InterstitialTech/seismobot-hardware/kicad/seismobot-hardware.png

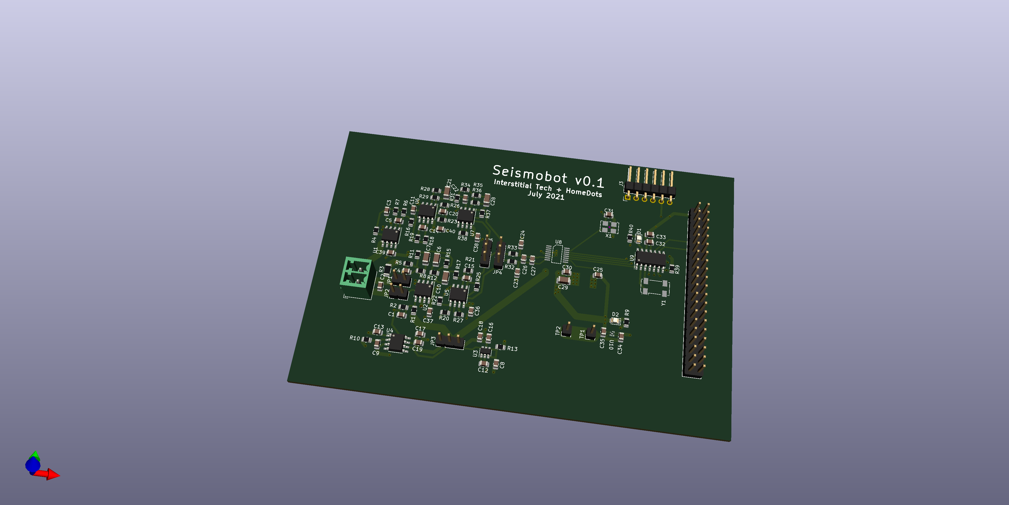
kicad/seismobot-hardware.png
