InterstitialTech/seismobot-hardware/README.md

# seismobot-hardware
Geophone DAQ board: KiCad project files

Schematic
