InterstitialTech/seismobot-hardware/kicad-mini/seismobot-hardware-mini/seismobot-hardware-mini-quad-solid.kicad_pcb

## KiCad design kicad-mini/seismobot-hardware-mini/seismobot-hardware-mini-quad-solid.kicad_pcb (2022-04-04)

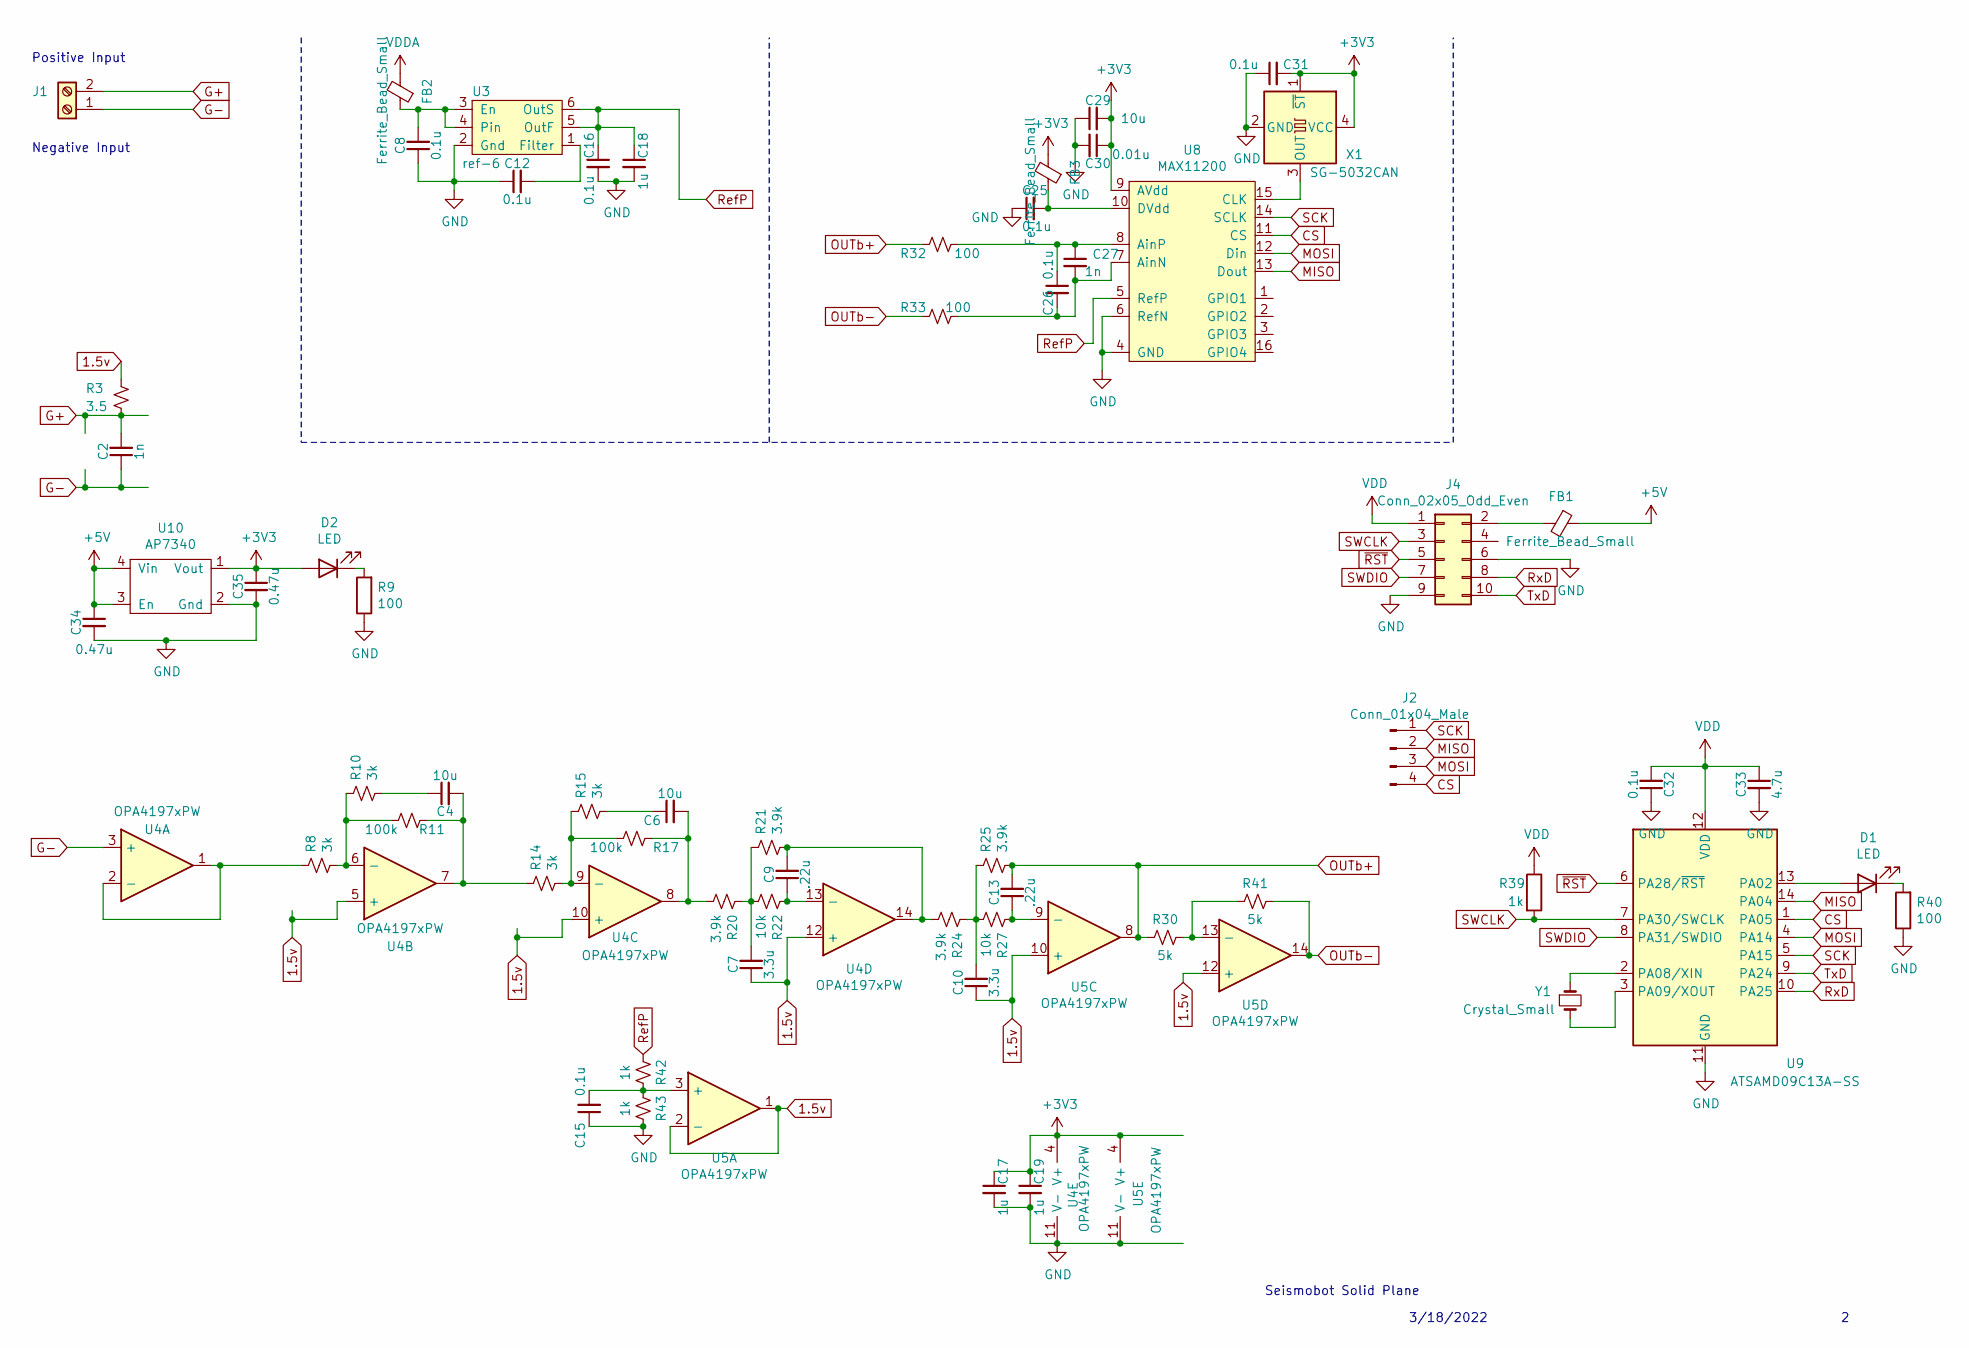
[picture p2: schematic seismobot-hardware-mini-quad-solid.sch]

Parts:
C2, C27: 1n; C_0805_2012Metric
C4, C6, C29: 10u; C_1206_3216Metric
C7, C10: 3.3u; C_0805_2012Metric
C8, C12, C15, C16, C25, C26, C31, C32: 0.1u; C_0805_2012Metric
C9, C13: .22u; C_0805_2012Metric
C17, C18, C19: 1u; C_0805_2012Metric
C30: 0.01u; C_0805_2012Metric
C33: 4.7u; C_0805_2012Metric
C34, C35: 0.47u; C_0805_2012Metric
D1, D2: LED; LED_0805_2012Metric
FB1, FB2, FB3: Ferrite_Bead_Small; R_0805_2012Metric
J1: Screw_Terminal_01x02; PhoenixContact_MCV_1,5_2-G-3.5_1x02_P3.50mm_Vertical
J2: Conn_01x04_Male; PinHeader_1x04_P1.27mm_Vertical
J4: Conn_02x05_Odd_Even; PinSocket_2x05_P2.54mm_Vertical
R3: 3.5; R_1206_3216Metric
R8, R10, R14, R15: 3k; R_0805_2012Metric
R9, R32, R33, R40: 100; R_0805_2012Metric
R11, R17: 100k; R_0805_2012Metric
R20, R21, R24, R25: 3.9k; R_0805_2012Metric
R22, R27: 10k; R_0805_2012Metric
R30, R41: 5k; R_0805_2012Metric
R39, R42, R43: 1k; R_0805_2012Metric
U3: ref-6; SOT-23-6
U4, U5: OPA4197xPW; SOIC-14_3.9x8.7mm_P1.27mm
U8: MAX11200; QSOP-16
U9: ATSAMD09C13A-SS; SOIC-14_3.9x8.7mm_P1.27mm
U10: AP7340; DFN-1010-4
X1: SG-5032CAN; Oscillator_SMD_SeikoEpson_SG8002LB-4Pin_5.0x3.2mm
Y1: Crystal_Small; Crystal_SMD_3215-2Pin_3.2x1.5mm

Connections:
1.5v: C7.1, C10.1, R3.1, U4.5 (+), U4.10 (+), U4.12 (+), U5.1, U5.2 (-), U5.10 (+), U5.12 (+)
+5V: C34.1, FB1.1, U10.3 (En), U10.4 (Vin)
CS: J2.4, U8.11 (CS), U9.1 (PA05)
G+: C2.2, J1.2, R3.2
G-: C2.1, J1.1, U4.3 (+)
GND: C8.1, C12.1, C15.1, C16.2, C17.2, C18.2, C19.2, C25.1, C29.1, C30.2, C31.1, C32.1, C33.2, C34.2, C35.2, J4.6, J4.9, R9.1, R40.1, R43.1, U3.2 (Gnd), U4.11 (V-), U5.11 (V-), U8.4 (GND), U8.6 (RefN), U9.11 (GND), U10.2 (Gnd), X1.2 (GND); also elsewhere on the board
MISO: J2.2, U8.13 (Dout), U9.14 (PA04)
MOSI: J2.3, U8.12 (Din), U9.4 (PA14)
unnamed: C4.1, R10.2
unnamed: C4.2, R11.1, R14.1, U4.7
unnamed: C6.1, R15.2
unnamed: C6.2, R17.1, R20.2, U4.8
unnamed: C7.2, R20.1, R21.1, R22.2
unnamed: C8.2, FB2.1, U3.3 (En), U3.4
unnamed: C9.1, R22.1, U4.13 (-)
unnamed: C9.2, R21.2, R24.2, U4.14
unnamed: C10.2, R24.1, R25.1, R27.2
unnamed: C12.2, U3.1 (Filter)
unnamed: C13.1, R27.1, U5.9 (-)
unnamed: C15.2, R42.1, R43.2, U5.3 (+)
unnamed: C26.1, C27.1, R32.1, U8.8 (AinP)
unnamed: C26.2, C27.2, R33.1, U8.7 (AinN)
unnamed: D1.1 (K), R40.2
unnamed: D1.2 (A), U9.13 (PA02)
unnamed: D2.1 (K), R9.2
unnamed: FB1.2, J4.2
unnamed: R8.1, U4.1, U4.2 (-)
unnamed: R8.2, R10.1, R11.2, U4.6 (-)
unnamed: R14.2, R15.1, R17.2, U4.9 (-)
unnamed: R30.1, R41.2, U5.13 (-)
unnamed: U8.15 (CLK), X1.3 (OUT)
unnamed: U9.2 (PA08/XIN), Y1.1
unnamed: U9.3 (PA09/XOUT), Y1.2
OUTb+: C13.2, R25.2, R30.2, R32.2, U5.8
OUTb-: R33.2, R41.1, U5.14
RefP: C16.1, C18.1, R42.2, U3.5 (OutF), U3.6 (OutS), U8.5 (RefP)
RxD: J4.8, U9.10 (PA25)
SCK: J2.1, U8.14 (SCLK), U9.5 (PA15)
SWCLK: J4.3, R39.2, U9.7 (PA30/SWCLK)
SWDIO: J4.7, U9.8 (PA31/SWDIO)
TxD: J4.10, U9.9 (PA24)
VDD: C32.2, C33.1, J4.1, R39.1, U9.12 (VDD); also elsewhere on the board
~RST: J4.5, U9.6 (PA28/~RST)

Notes on the sheet:
Negative Input
Positive Input
Seismobot Solid Plane
3/18/2022

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
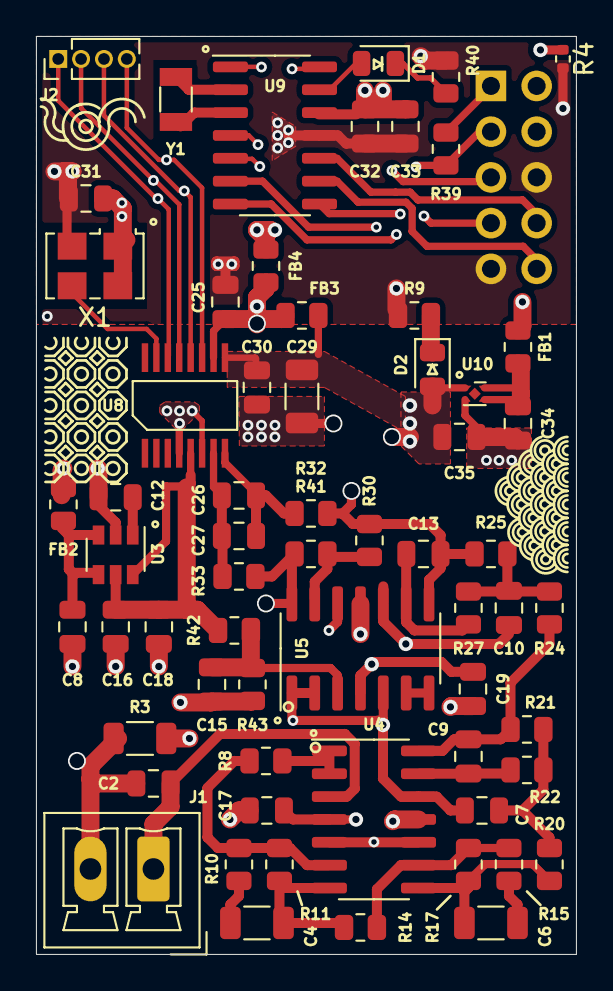
[picture p3: board seismobot-hardware-mini-quad-solid.kicad_pcb from above]

Board: 4 copper layers, 30.0 x 51.0 mm, 64 parts (1 on the bottom side), 45 nets.

Other parts of the board:
FB4: 0; R_0805_2012Metric
R4: 0; R_0402_1005Metric

Their connections:
GND: R4.2; also elsewhere on the board
VDD: FB4.1; also elsewhere on the board
