InterstitialTech/seismobot-hardware/kicad/seismobot-hardware.kicad_pcb

## KiCad design kicad/seismobot-hardware.kicad_pcb (2021-11-17)

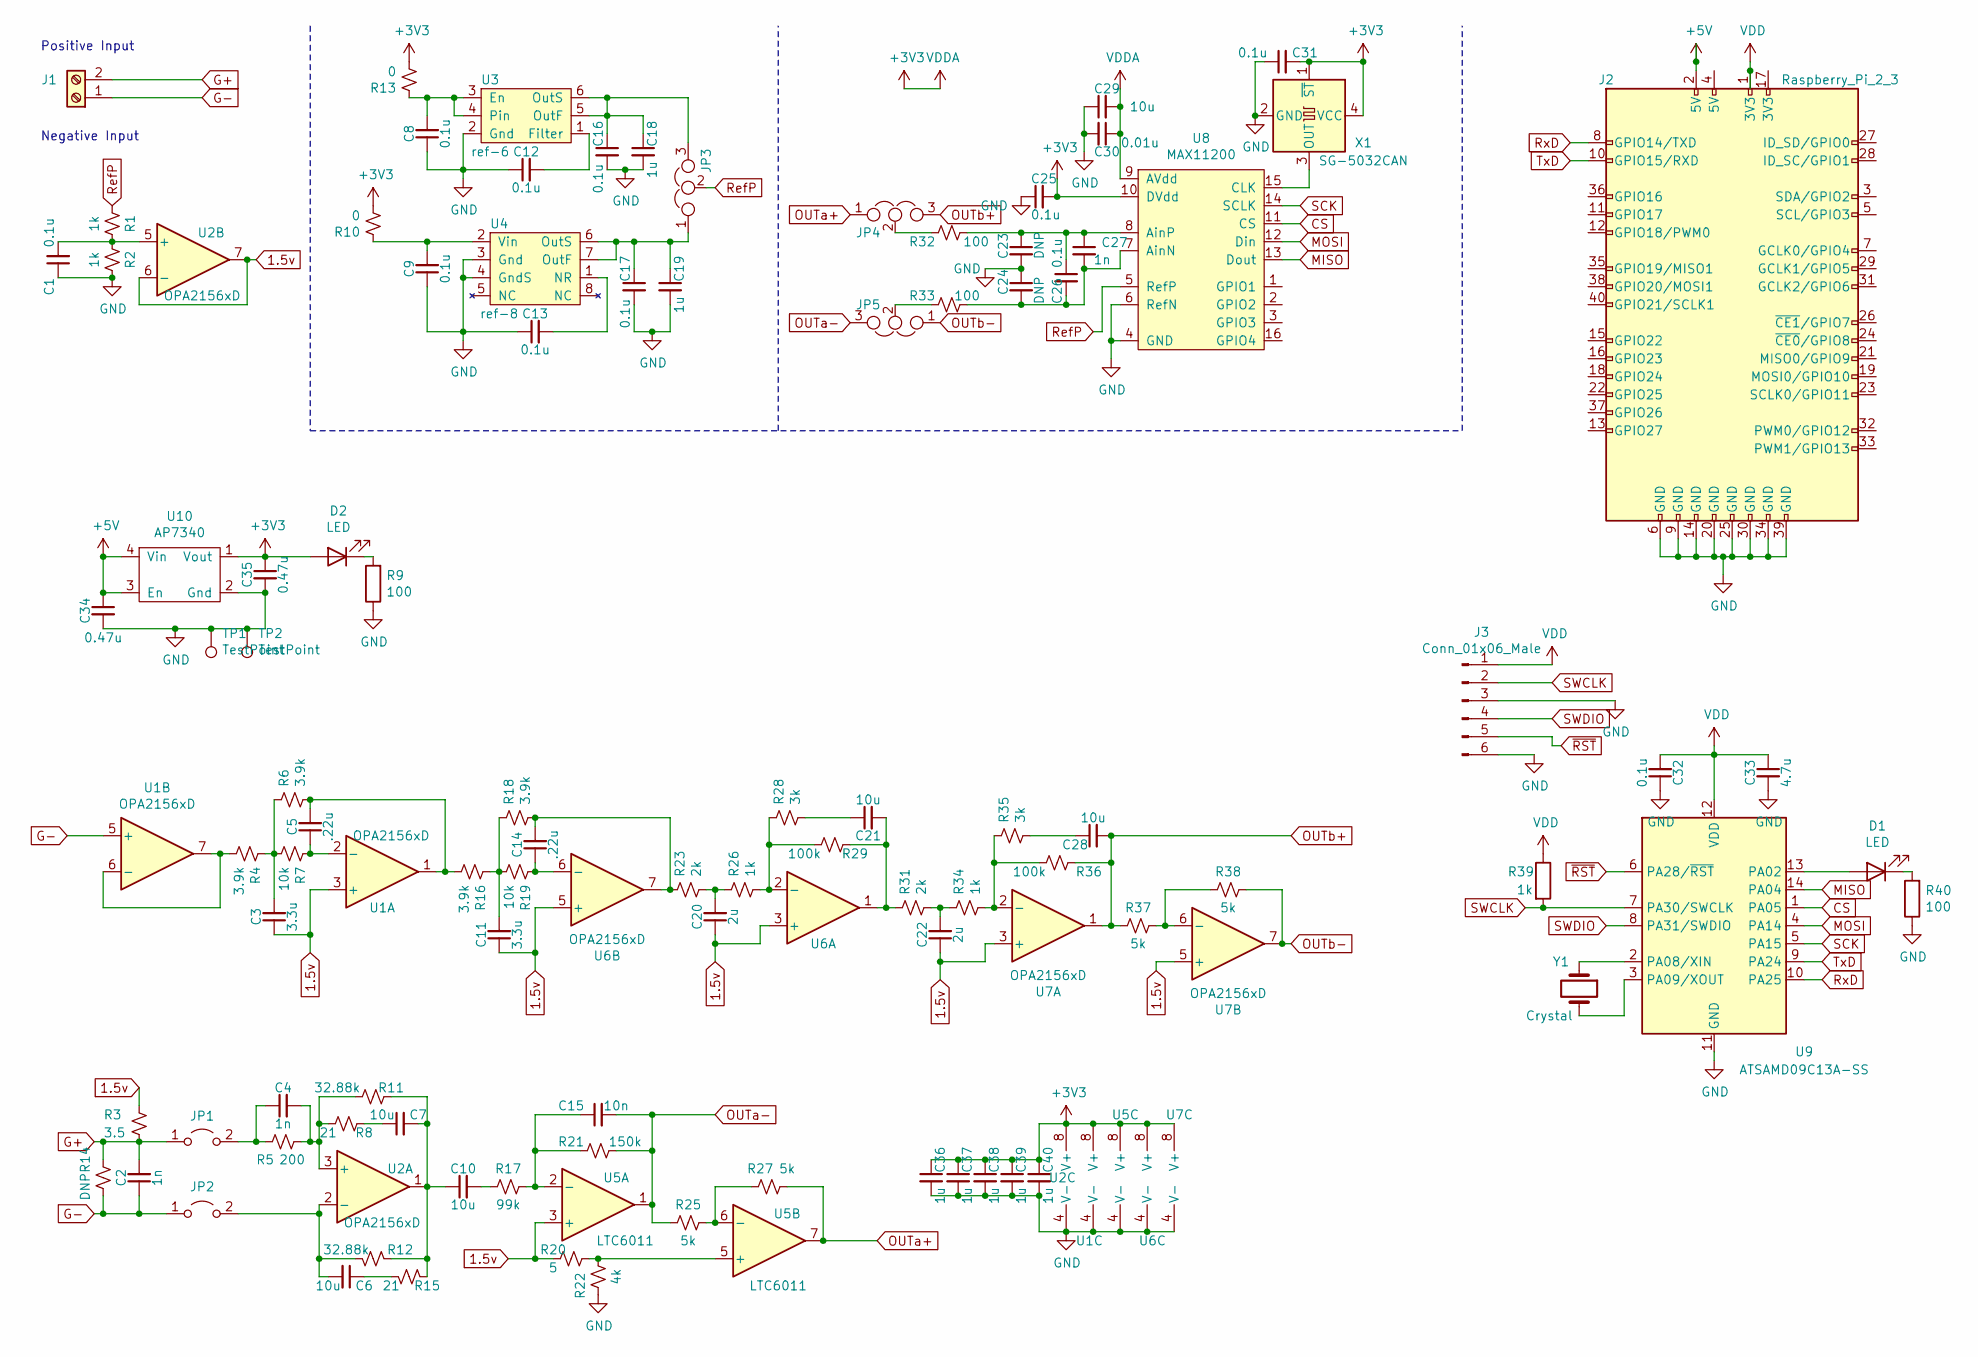
[picture p4: schematic seismobot-hardware.sch]

Parts:
C1, C8, C9, C12, C13, C16, C17, C25, C26, C31, C32: 0.1u; C_0805_2012Metric
C2, C4, C27: 1n; C_0805_2012Metric
C3, C11: 3.3u; C_0805_2012Metric
C5, C14: .22u; C_0805_2012Metric
C6, C7, C10, C21, C28, C29: 10u; C_1206_3216Metric
C15: 10n; C_0805_2012Metric
C18, C19, C36, C37, C38, C39, C40: 1u; C_0805_2012Metric
C20, C22: 2u; C_0805_2012Metric
C23, C24: DNP; C_0805_2012Metric
C30: 0.01u; C_0805_2012Metric
C33: 4.7u; C_0805_2012Metric
C34, C35: 0.47u; C_0805_2012Metric
D1, D2: LED; LED_0805_2012Metric
J1: Screw_Terminal_01x02; PhoenixContact_MCV_1,5_2-G-3.5_1x02_P3.50mm_Vertical
J2: Raspberry_Pi_2_3; PinHeader_2x20_P2.54mm_Vertical
J3: Conn_01x06_Male; PinHeader_1x06_P2.54mm_Horizontal
JP1, JP2: Jumper_2_Open; PinHeader_1x02_P2.54mm_Vertical
JP3, JP4, JP5: Jumper_NC_Dual; PinHeader_1x03_P2.54mm_Vertical
R1, R2, R26, R34, R39: 1k; R_0805_2012Metric
R3: 3.5; R_1206_3216Metric
R4, R6, R16, R18: 3.9k; R_0805_2012Metric
R5: 200; R_0805_2012Metric
R7, R19: 10k; R_0805_2012Metric
R8, R15: 21; R_0805_2012Metric
R9, R32, R33, R40: 100; R_0805_2012Metric
R10, R13: 0; R_0805_2012Metric
R11, R12: 32.88k; R_0805_2012Metric
R14: DNP; R_0805_2012Metric
R17: 99k; R_0805_2012Metric
R20: 5; R_0805_2012Metric
R21: 150k; R_0805_2012Metric
R22: 4k; R_0805_2012Metric
R23, R31: 2k; R_0805_2012Metric
R25, R27, R37, R38: 5k; R_0805_2012Metric
R28, R35: 3k; R_0805_2012Metric
R29, R36: 100k; R_0805_2012Metric
TP1, TP2: TestPoint; PinHeader_1x01_P2.54mm_Vertical
U1, U2, U6, U7: OPA2156xD; SOIC-8_3.9x4.9mm_P1.27mm
U3: ref-6; SOT-23-6
U4: ref-8; SOIC-8_3.9x4.9mm_P1.27mm
U5: LTC6011; SOIC-8_3.9x4.9mm_P1.27mm
U8: MAX11200; QSOP-16
U9: ATSAMD09C13A-SS; SOIC-14_3.9x8.7mm_P1.27mm
U10: AP7340; DFN-1010-4
X1: SG-5032CAN; Oscillator_SMD_SeikoEpson_SG8002LB-4Pin_5.0x3.2mm
Y1: Crystal; Crystal_SMD_Suntsu_SWS83412D16-4Pin_8.0x3.8mm

Connections:
1.5v: C3.1, C11.1, C20.1, C22.1, R3.1, R20.2, U1.3 (+), U2.6 (-), U2.7, U5.3 (+), U6.3 (+), U6.5 (+), U7.3 (+), U7.5 (+)
+3V3: C25.2, C29.2, C30.1, C31.2, C35.1, C36.1, C37.1, C38.1, C39.1, C40.1, D2.2 (A), R10.1, R13.1, U1.8 (V+), U2.8 (V+), U5.8 (V+), U6.8 (V+), U7.8 (V+), U8.9 (AVdd), U8.10 (DVdd), U10.1 (Vout), X1.1 (~ST), X1.4 (VCC)
+5V: C34.1, J2.2 (5V), U10.3 (En), U10.4 (Vin)
CS: U8.11 (CS), U9.1 (PA05)
G+: C2.2, J1.2, JP1.1 (A), R3.2, R14.2
G-: C2.1, J1.1, JP2.1 (A), R14.1, U1.5 (+)
GND: C1.1, C8.1, C9.1, C12.1, C13.1, C16.2, C17.2, C18.2, C19.2, C23.2, C24.1, C25.1, C29.1, C30.2, C31.1, C32.1, C33.2, C34.2, C35.2, C36.2, C37.2, C38.2, C39.2, C40.2, J2.6 (GND), J2.9 (GND), J2.14 (GND), J2.20 (GND), J2.25 (GND), J2.30 (GND), J2.34 (GND), J2.39 (GND), J3.3, J3.6, R2.1, R9.1, R22.1, R40.1, TP1.1, TP2.1, U1.4 (V-), U2.4 (V-), U3.2 (Gnd), U4.3 (Gnd), U4.4 (GndS), U5.4 (V-), U6.4 (V-), U7.4 (V-), U8.4 (GND), U8.6 (RefN), U9.11 (GND), U10.2 (Gnd), X1.2 (GND)
MISO: U8.13 (Dout), U9.14 (PA04)
MOSI: U8.12 (Din), U9.4 (PA14)
unnamed: C1.2, R1.1, R2.2, U2.5 (+)
unnamed: C3.2, R4.1, R6.1, R7.2
unnamed: C4.1, JP1.2 (B), R5.2
unnamed: C4.2, R5.1, R8.2, R11.2, U2.3 (+)
unnamed: C5.1, R7.1, U1.2 (-)
unnamed: C5.2, R6.2, R16.2, U1.1
unnamed: C6.1, R15.1
unnamed: C6.2, JP2.2 (B), R12.1, U2.2 (-)
unnamed: C7.1, R8.1
unnamed: C8.2, R13.2, U3.3 (En), U3.4
unnamed: C9.2, R10.2, U4.2 (Vin)
unnamed: C7.2, C10.1, R11.1, R12.2, R15.2, U2.1
unnamed: C10.2, R17.2
unnamed: C11.2, R16.1, R18.1, R19.2
unnamed: C12.2, U3.1 (Filter)
unnamed: C13.2, U4.1 (NR)
unnamed: C14.1, R19.1, U6.6 (-)
unnamed: C14.2, R18.2, R23.1, U6.7
unnamed: C15.1, R17.1, R21.2, U5.2 (-)
unnamed: C16.1, C18.1, JP3.3, U3.5 (OutF), U3.6 (OutS)
unnamed: C17.1, C19.1, JP3.1, U4.6 (OutS), U4.7 (OutF)
unnamed: C20.2, R23.2, R26.1
unnamed: C21.1, R28.2
unnamed: C21.2, R29.1, R31.1, U6.1
unnamed: C22.2, R31.2, R34.1
unnamed: C23.1, C26.1, C27.1, R32.1, U8.8 (AinP)
unnamed: C24.2, C26.2, C27.2, R33.1, U8.7 (AinN)
unnamed: C28.1, R35.2
unnamed: D1.1 (K), R40.2
unnamed: D1.2 (A), U9.13 (PA02)
unnamed: D2.1 (K), R9.2
unnamed: JP4.2, R32.2
unnamed: JP5.2, R33.2
unnamed: R4.2, U1.6 (-), U1.7
unnamed: R20.1, R22.2, U5.5 (+)
unnamed: R25.1, R27.2, U5.6 (-)
unnamed: R26.2, R28.1, R29.2, U6.2 (-)
unnamed: R34.2, R35.1, R36.2, U7.2 (-)
unnamed: R37.1, R38.2, U7.6 (-)
unnamed: U8.15 (CLK), X1.3 (OUT)
unnamed: U9.2 (PA08/XIN), Y1.1
unnamed: U9.3 (PA09/XOUT), Y1.4
OUTa+: JP4.1, R27.1, U5.7
OUTa-: C15.2, JP5.3, R21.1, R25.2, U5.1
OUTb+: C28.2, JP4.3, R36.1, R37.2, U7.1
OUTb-: JP5.1, R38.1, U7.7
RefP: JP3.2, R1.2, U8.5 (RefP)
RxD: J2.8 (GPIO14/TXD), U9.10 (PA25)
SCK: U8.14 (SCLK), U9.5 (PA15)
SWCLK: J3.2, R39.2, U9.7 (PA30/SWCLK)
SWDIO: J3.4, U9.8 (PA31/SWDIO)
TxD: J2.10 (GPIO15/RXD), U9.9 (PA24)
VDD: C32.2, C33.1, J2.1 (3V3), J3.1, R39.1, U9.12 (VDD)
~RST: J3.5, U9.6 (PA28/~RST)

Notes on the sheet:
Negative Input
Positive Input

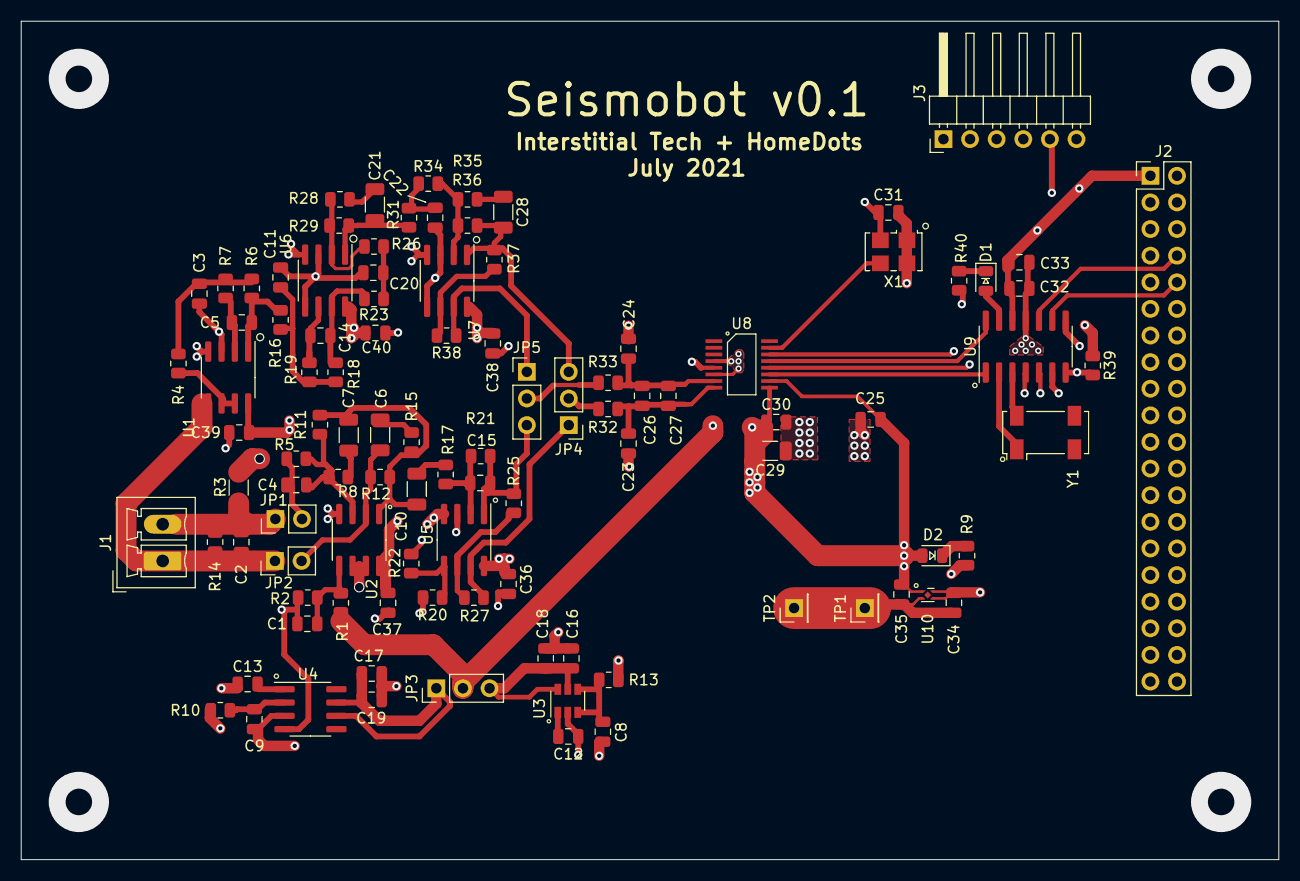
[picture p5: board seismobot-hardware.kicad_pcb from above]

Board: 4 copper layers, 120.0 x 80.0 mm, 102 parts (0 on the bottom side), 63 nets.
