InterstitialTech/seismobot-hardware/(commit log)

2021-04-29 add bom.csv
    [bom.csv]
2021-04-30 bom.csv: change from 26 to 40 pin header
    [bom.csv]
2021-05-05 added kicad project
    [seismobot-hardware.kicad_pcb, seismobot-hardware.sch]
2021-05-05 raspberry pi header and mcu on schematic
    [seismobot-hardware.sch]
2021-05-19 add MCU (ATSAMD09) and supporting circuitry
    [bom.csv, prebom.csv, seismobot-hardware.sch]
2021-05-21 Added passives and clock to ADC
    Based off of dev board
    [seismobot-hardware.sch]
2021-05-21 started noise calculations
    [geophone-calcs.ods]
2021-05-22 added noise analysis
    [geophone-calcs.ods]
2021-05-22 added voltage reference symbols
2021-05-22 added voltage references to schematic
    [seismobot-hardware.sch]
2021-05-23 add input stage 1
    [seismobot-hardware.sch]
2021-06-14 Cleaned things up, add new signal path
    added a new 6-pole, 2-zero filter
    [geophone-calcs.ods, seismobot-hardware.sch]
2021-06-14 add jumpers for signal path selection
    [seismobot-hardware.sch]
2021-06-14 add footprints to all components
    [prebom.csv, seismobot-hardware.sch]
2021-06-16 add v1 signal path routing
    [seismobot-hardware.kicad_pcb, seismobot-hardware.sch]
2021-06-16 add v2 signal path routing
    [seismobot-hardware.kicad_pcb, seismobot-hardware.sch]
2021-06-27 add 3v3 regulator, simplify signal split, add planes
    [geophone-calcs.ods, seismobot-hardware.kicad_pcb, seismobot-hardware.sch]
2021-06-30 add 3v3 regulator, more routing
    [prebom.csv]
2021-06-30 add 3v3 power led
    [seismobot-hardware.kicad_pcb, seismobot-hardware.sch]
2021-06-30 resize board
    [seismobot-hardware.kicad_pcb]
2021-07-24 finishing touches before sending out rev 1
    [seismobot-hardware.kicad_pcb, seismobot-hardware.sch]
2021-07-24 add BOM
    [seismobot-hardware.csv]
2021-07-24 add v1 gerbers
2021-08-23 re-arrange schematic for aesthetics, add Title Block
    [seismobot-hardware.sch]
2021-08-23 sym-lib-table, cache and rescue files for kicad v5.1.5
2021-08-23 README: add schematic
2021-11-17 not sure what changed here, sorry
    [seismobot-hardware.ods]
2021-11-17 cleaning things up
    [seismobot-hardware.sch]
2021-11-17 playing with more numbers
    [geophone-calcs.ods]
2022-04-04 add mini-quad-solid
    [seismobot-hardware-mini-quad-solid.kicad_pcb, seismobot-hardware-mini-quad-solid.sch]
